Dwilliestyle/Indigo-Bot/images/20260718_103444.jpg

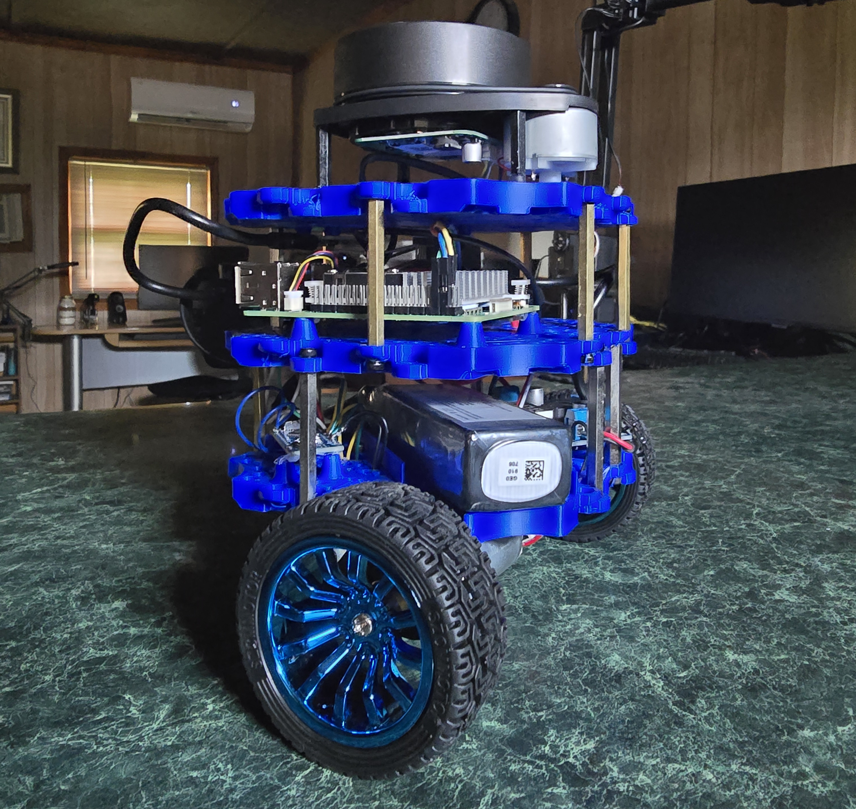
images/20260718_103444.jpg
