Dwilliestyle/Indigo-Bot/images/20260917_102831.jpg

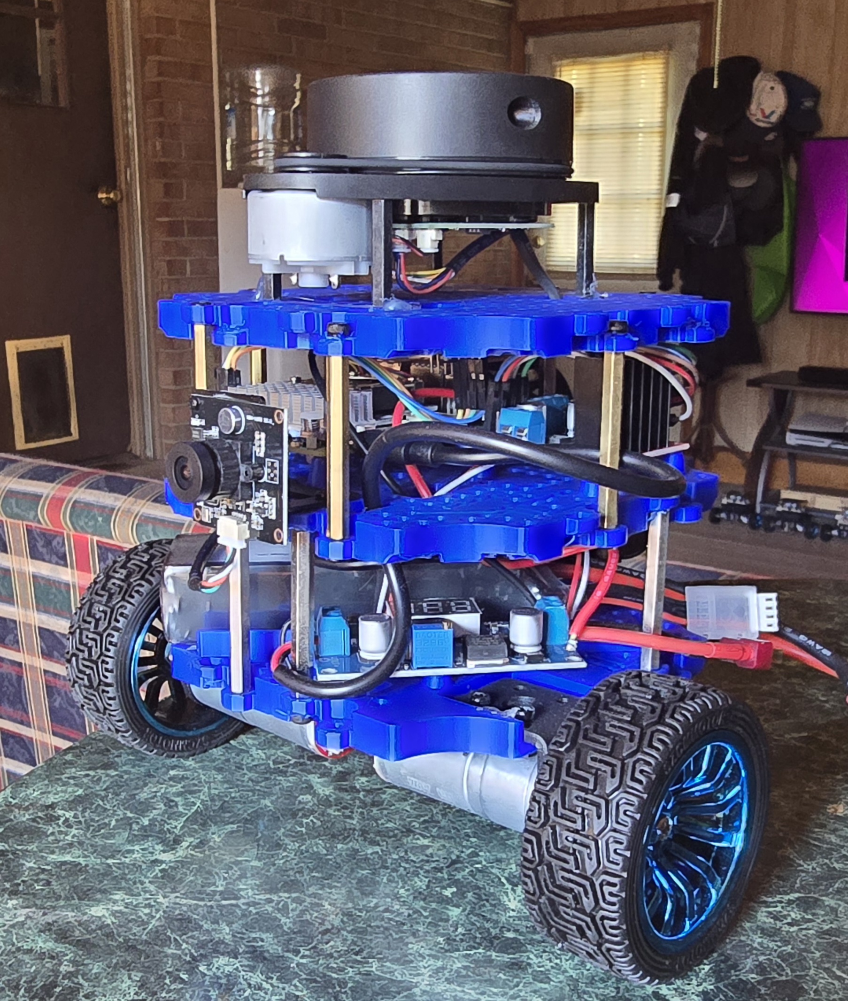
images/20260917_102831.jpg
