Dwilliestyle/Indigo-Bot/images/20261001_111405.jpg

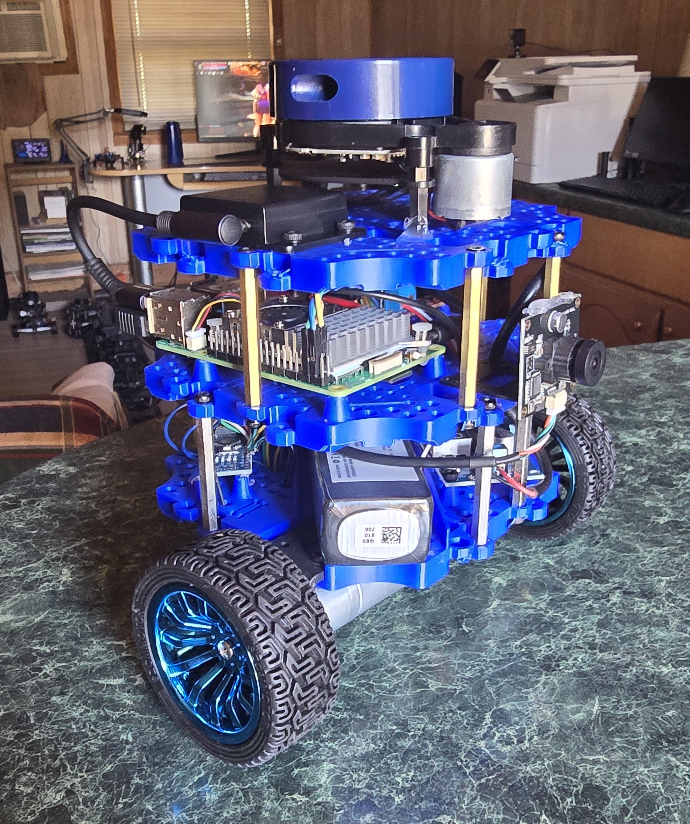
images/20261001_111405.jpg
