Dwilliestyle/Indigo-Bot/indigo_description/meshes/ydlidar_x2l.stl

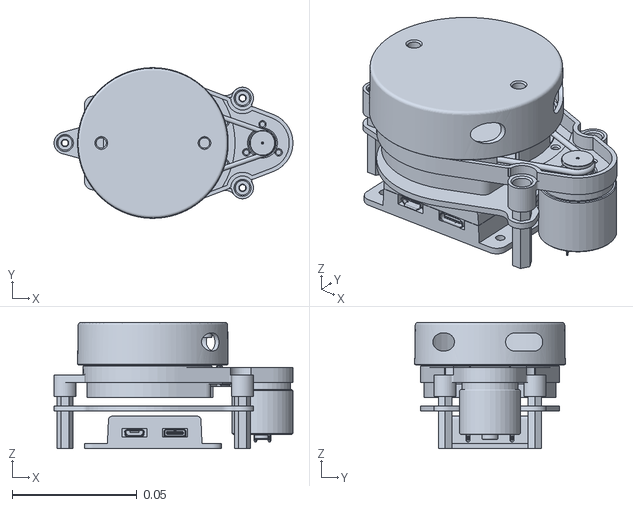
[picture p5: CAD file, 2026-09-28]
indigo_description/meshes/ydlidar_x2l.stl
0.0959 x 0.0605 x 0.0507
