Dwilliestyle/Indigo-Bot/indigo_description/meshes/camera_link.STL

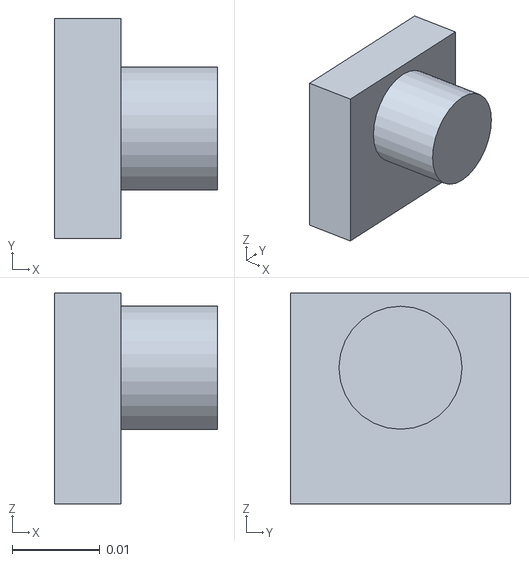
[picture p6: CAD file, 2026-09-17]
indigo_description/meshes/camera_link.STL
0.0186 x 0.025 x 0.024
