Dwilliestyle/Indigo-Bot/indigo_description/meshes/imu_link.STL

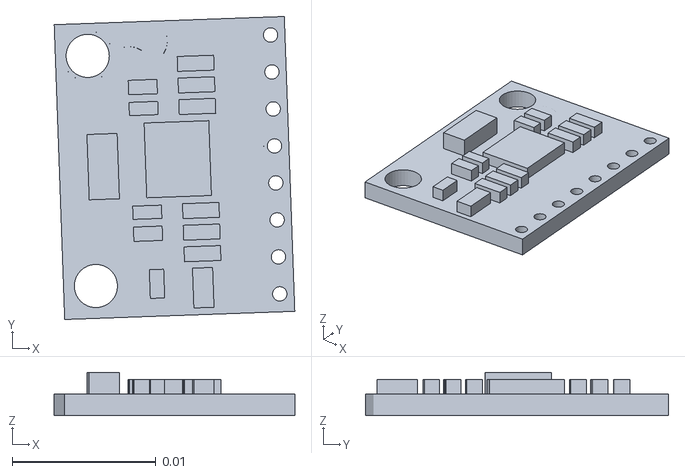
[picture p7: CAD file, 2026-08-22]
indigo_description/meshes/imu_link.STL
0.0167 x 0.0211 x 0.003
