Dwilliestyle/Indigo-Bot/indigo_description/meshes/wheel_right_link.STL

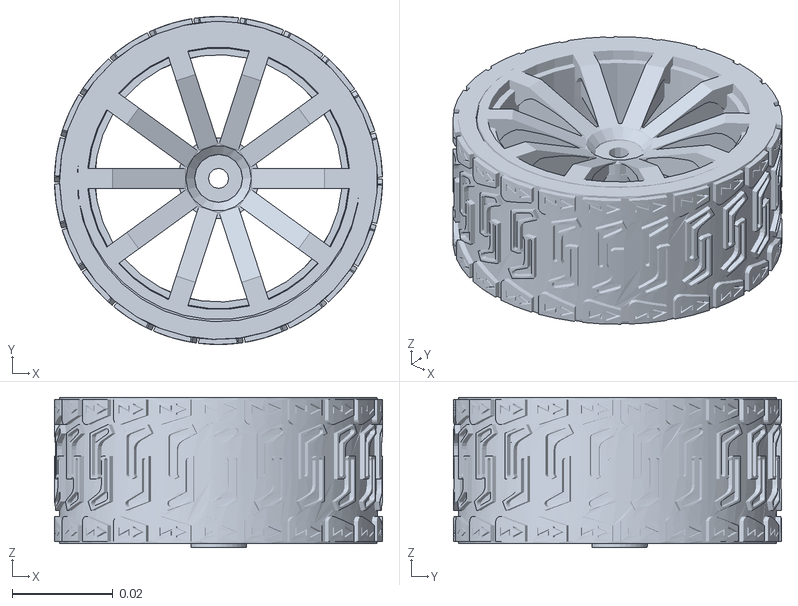
[picture p8: CAD file, 2026-08-22]
indigo_description/meshes/wheel_right_link.STL
0.065 x 0.065 x 0.0298
