Dwilliestyle/Indigo-Bot/indigo_description/meshes/base_link.STL

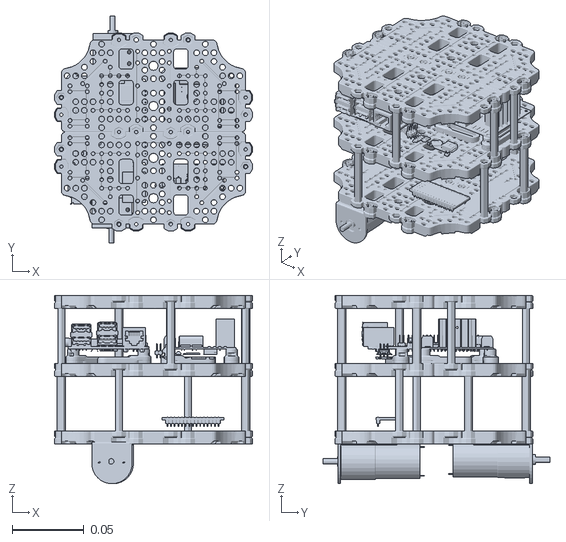
[picture p9: CAD file, 2026-08-22]
indigo_description/meshes/base_link.STL
0.138 x 0.158 x 0.131
