Dwilliestyle/Indigo-Bot/indigo_description/meshes/laser_link.STL

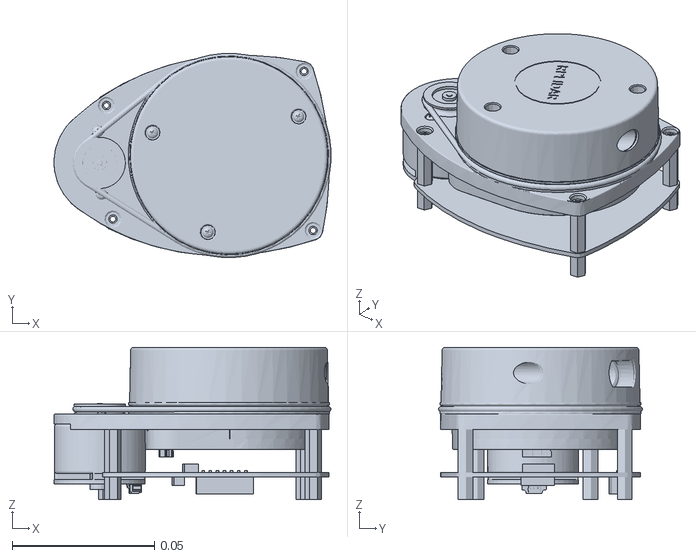
[picture p10: CAD file, 2026-08-22]
indigo_description/meshes/laser_link.STL
0.0973 x 0.0717 x 0.0535
