Dwilliestyle/Indigo-Bot/(list of files, cad)

Other CAD files:
indigo_description/meshes/wheel_left_link.STL
