Dwilliestyle/Indigo-Bot/indigo_control/config/indigobot_controller.yaml

controller_manager:
  ros__parameters:
    update_rate: 100 # Hz

    indigobot_controller:
      type: diff_drive_controller/DiffDriveController

    joint_state_broadcaster:
      type: joint_state_broadcaster/JointStateBroadcaster


indigobot_controller:
  ros__parameters:
    use_stamped_vel: true
    # wheel names were switched on purpose
    left_wheel_names  : ['wheel_left_joint']
    right_wheel_names : ['wheel_right_joint']

    publish_rate: 50.0               # default: 50
    pose_covariance_diagonal : [0.001, 0.001, 1.0e-3, 1.0e-3, 1.0e-3, 0.01]
    twist_covariance_diagonal: [0.001, 0.001, 1.0e-3, 1.0e-3, 1.0e-3, 0.01]

    wheel_separation : 0.17
    wheel_radius : 0.034

    wheel_separation_multiplier: 1.0
    left_wheel_radius_multiplier: 1.0
    right_wheel_radius_multiplier: 1.0

    # Velocity commands timeout [s], default 0.5
    cmd_vel_timeout: 0.5

    # Base frame_id
    base_frame_id: base_footprint #default: base_link

    # Publish limited velocity
    publish_limited_velocity: true

    # Publish wheel data
    publish_wheel_data: true

    # Publish to TF directly or not
    enable_odom_tf: false

    # Velocity and acceleration limits
    # Whenever a min_* is unspecified, default to -max_*
    linear:
      x:
        has_velocity_limits    : true
        max_velocity           : 0.4  # m/s
        min_velocity           : -0.4 # m/s
        has_acceleration_limits: true
        max_acceleration       : 0.4  # m/s^2
        min_acceleration       : -0.4 # m/s^2
        
    angular:
      z:
        has_velocity_limits    : true
        max_velocity           : 1.5  # rad/s
        min_velocity           : -1.5  # rad/s
        has_acceleration_limits: true
        max_acceleration       : 1.0  # rad/s^2
        min_acceleration       : -1.0   # rad/s^2
        
