Dwilliestyle/Indigo-Bot/(commit log)

2026-07-14 Initial commit - working ros2_control stack
    [Lidar_assy - Lidar_holder-1.STL, Lidar_assy - YDLIDAR_X2_Assy-1 Part_1-1.STL, Lidar_assy - YDLIDAR_X2_Assy-1 Part_2-1.STL, Lidar_assy - YDLIDAR_X2_Assy-1 Part_3-1.STL, Lidar_assy - YDLIDAR_X2_Assy-1 Part_4-1.STL, Lidar_assy - YDLIDAR_driver-2.STL, indigo.urdf.xacro, indigobot_controller.yaml]
2026-07-21 README started. Work in progress
    [indigobot_controller.yaml]
2026-08-01 stored the arduino robot control file
2026-08-07 added MPU driver node and launch file
2026-08-22 Created new URDF model of the robot
    [Lidar_assy - Lidar_holder-1.STL, Lidar_assy - YDLIDAR_X2_Assy-1 Part_1-1.STL, Lidar_assy - YDLIDAR_X2_Assy-1 Part_2-1.STL, Lidar_assy - YDLIDAR_X2_Assy-1 Part_3-1.STL, Lidar_assy - YDLIDAR_X2_Assy-1 Part_4-1.STL, Lidar_assy - YDLIDAR_X2_Assy-1 Part_5-1.STL, Lidar_assy - YDLIDAR_driver-2.STL, base_link.STL]
2026-09-15 Update mpu_driver.py with corrected numbers
    [mpu_driver.py]
2026-09-17 Updated and corrected URDF model
    [indigobot.urdf.xacro]
2026-09-17 updated URDF model
    [indigobot.urdf.xacro]
2026-09-17 added camera to URDF
    [camera_link.STL, indigobot.urdf.xacro]
2026-09-17 added a camera and functionalities to the robot
2026-09-17 Updated robot image with camera
2026-09-28 Added new LIDAR model to the robot
    [indigobot.urdf.xacro, ydlidar_x2l.stl]
2026-09-29 Added new LIDAR YAML file
2026-09-30 added new LIDAR
2026-09-30 Corrected the hardware interfaces and the xacro files
    [indigobot.urdf.xacro, indigobot_ros2_control.xacro]
2026-09-30 Modify YDLIDAR configuration in ydlidar.yaml
    Updated YDLIDAR configuration parameters including port, baudrate, and lidar settings.
2026-09-30 Added a simple LIDAR test launch file
2026-09-30 Ignore ydlidar driver
2026-10-10 Use /dev/arduino and /dev/lidar udev names
2026-10-10 udev device names, re-enable lidar motor control
2026-10-18 Update chassis material from PETG to PLA
2026-10-19 Refactor MPU driver initialization and calibration
2026-10-20 Send command to Arduino before closing connection
2026-10-23 Move sketch into arduino-cli folder
2026-10-23 Modified robot_control for arduino
2026-10-23 tweaked PID values
2026-10-23 Actual wheel radius
2026-10-24 Add camera publisher node to launch file
2026-10-24 Rename camera_publisher executable in launch file
2026-10-24 Enhance camera publisher with frame_id and logging
    Added frame_id parameter and improved camera initialization logging.
2026-10-24 Added camera viewing to launch files
2026-10-30 corrected wheel names and positions
2026-11-06 Adding LIDAR mapping test
2026-11-06 Added QOS to lidar scan publisher
